Dynamic0823/MacroPad/Kicad/MacroPadV2BOM.ods

Item | Qty | Reference(s) | Value | LibPart | Footprint | Datasheet | DigikeyPN | Field4
1 | 2 | C1, C2 | 15pF | Device:C_Small | Capacitor_SMD:C_0805_2012Metric_Pad1.18x1.45mm_HandSolder | ~ | 311-1101-2-ND
2 | 3 | C3, C4, C5 | 100nF | Device:C_Small | Capacitor_SMD:C_0805_2012Metric_Pad1.18x1.45mm_HandSolder | ~ | 3372-MT05B104M500BDTR-ND
3 | 1 | C6 | 1uF | Device:C_Small | Capacitor_SMD:C_0805_2012Metric_Pad1.18x1.45mm_HandSolder | ~ | 1276-1003-2-ND
4 | 3 | C7, C8, C9 | 4.7uF | Device:C_Small | Capacitor_SMD:C_0805_2012Metric_Pad1.18x1.45mm_HandSolder | ~ | 1276-1244-2-ND
5 | 12 | D1, D2, D3, D4, D5, D6, D7, D8, D9, D10, D11, D12 | TS4148 RBG | symbols:1N4148WX-TP | Diode_SMD:D_0805_2012Metric_Pad1.15x1.40mm_HandSolder |  | 1801-TS4148RBGTR-ND
6 | 1 | D13 | D | Device:D | Diode_SMD:D_0805_2012Metric_Pad1.15x1.40mm_HandSolder | ~ | 1801-TS4148RBGTR-ND
7 | 1 | F1 | OZCH | Device:Polyfuse_Small | mpadfps:OZCHFusr | ~ | 507-1792-2-ND
8 | 1 | H1 | M3Hole | :M3Hole_3 | mpadfps:M3Hole
9 | 1 | H2 | M3Hole | macropad_parts:M3Hole | mpadfps:M3Hole
10 | 1 | H3 | M3Hole | :M3Hole_2 | mpadfps:M3Hole
11 | 1 | H4 | M3Hole | :M3Hole_1 | mpadfps:M3Hole
12 | 3 | J1, J2, J4 | 3PinJump | macropad_parts:3PinJump | Connector_PinHeader_2.54mm:PinHeader_1x03_P2.54mm_Vertical
13 | 1 | J3 | GCT-USB4085 | symbols:GCT-USB4085 | mpadfps:USB4085-GF-A |  | 2073-USB4085-GF-ATR-ND
14 | 3 | J5, J6, J7 | 4PinJump | macropad_parts:4PinJump | Connector_PinHeader_2.54mm:PinHeader_1x04_P2.54mm_Vertical
15 | 12 | K1, K2, K3, K4, K5, K6, K7, K8, K9, K10, K11, K12 | KSW | macropad_parts:KSW | keyboard_fp:CherryMx |  | CH197-ND
16 | 5 | R1, R2, R4, R10, R11 | 10k | Device:R_Small_US | Resistor_SMD:R_0805_2012Metric_Pad1.20x1.40mm_HandSolder | ~ | RMCF0805JT10K0TR-ND
17 | 2 | R3, R5 | 5.1k | Device:R_Small_US | Resistor_SMD:R_0805_2012Metric_Pad1.20x1.40mm_HandSolder | ~ | RMCF0805JT5K10TR-ND
18 | 4 | R6, R7, R8, R9 | 1k | Device:R_Small_US | Resistor_SMD:R_0805_2012Metric_Pad1.20x1.40mm_HandSolder | ~ | RMCF0805FT1K00
19 | 2 | SW1, SW2 | SWITCH_TACTILE_SPST-NO_0.05A_12V | macropad_parts:SWITCH_TACTILE_SPST-NO_0.05A_12V | mpadfps:PTS645-G |  | CKN9085TR-ND
20 | 1 | SW3 | RotaryEncoder_Switch | Device:RotaryEncoder_Switch | mpadfps:PEC11H-RotaryEncoderSwitch | ~ | 118-PEC11H-4220F-S0024-ND
21 | 1 | U1 | STM32F103C8T6TR | symbols:STM32F103C8T6TR | macrofp:LQFP48 |  | 497-17666-2-ND
22 | 1 | U2 | AP2114HA-3.3TRG1 | macropad_parts:AP2114HA-3.3TRG1 | keyboard_fp:SOT-223_DIO-L |  | AP2114HA-3.3TRG1DITR-ND
23 | 1 | X1 | TSX-3225_16.0000MF18X-AC6 | macropad_parts:TSX-3225_16.0000MF18X-AC6 | mpadfps:TSX-3226 |  | SER4372TR-ND | OSC16MHz
