Dynamic0823/MacroPad/Kicad/MacroPadV2.kicad_pcb

## KiCad design Kicad/MacroPadV2.kicad_pcb (2024-02-11)

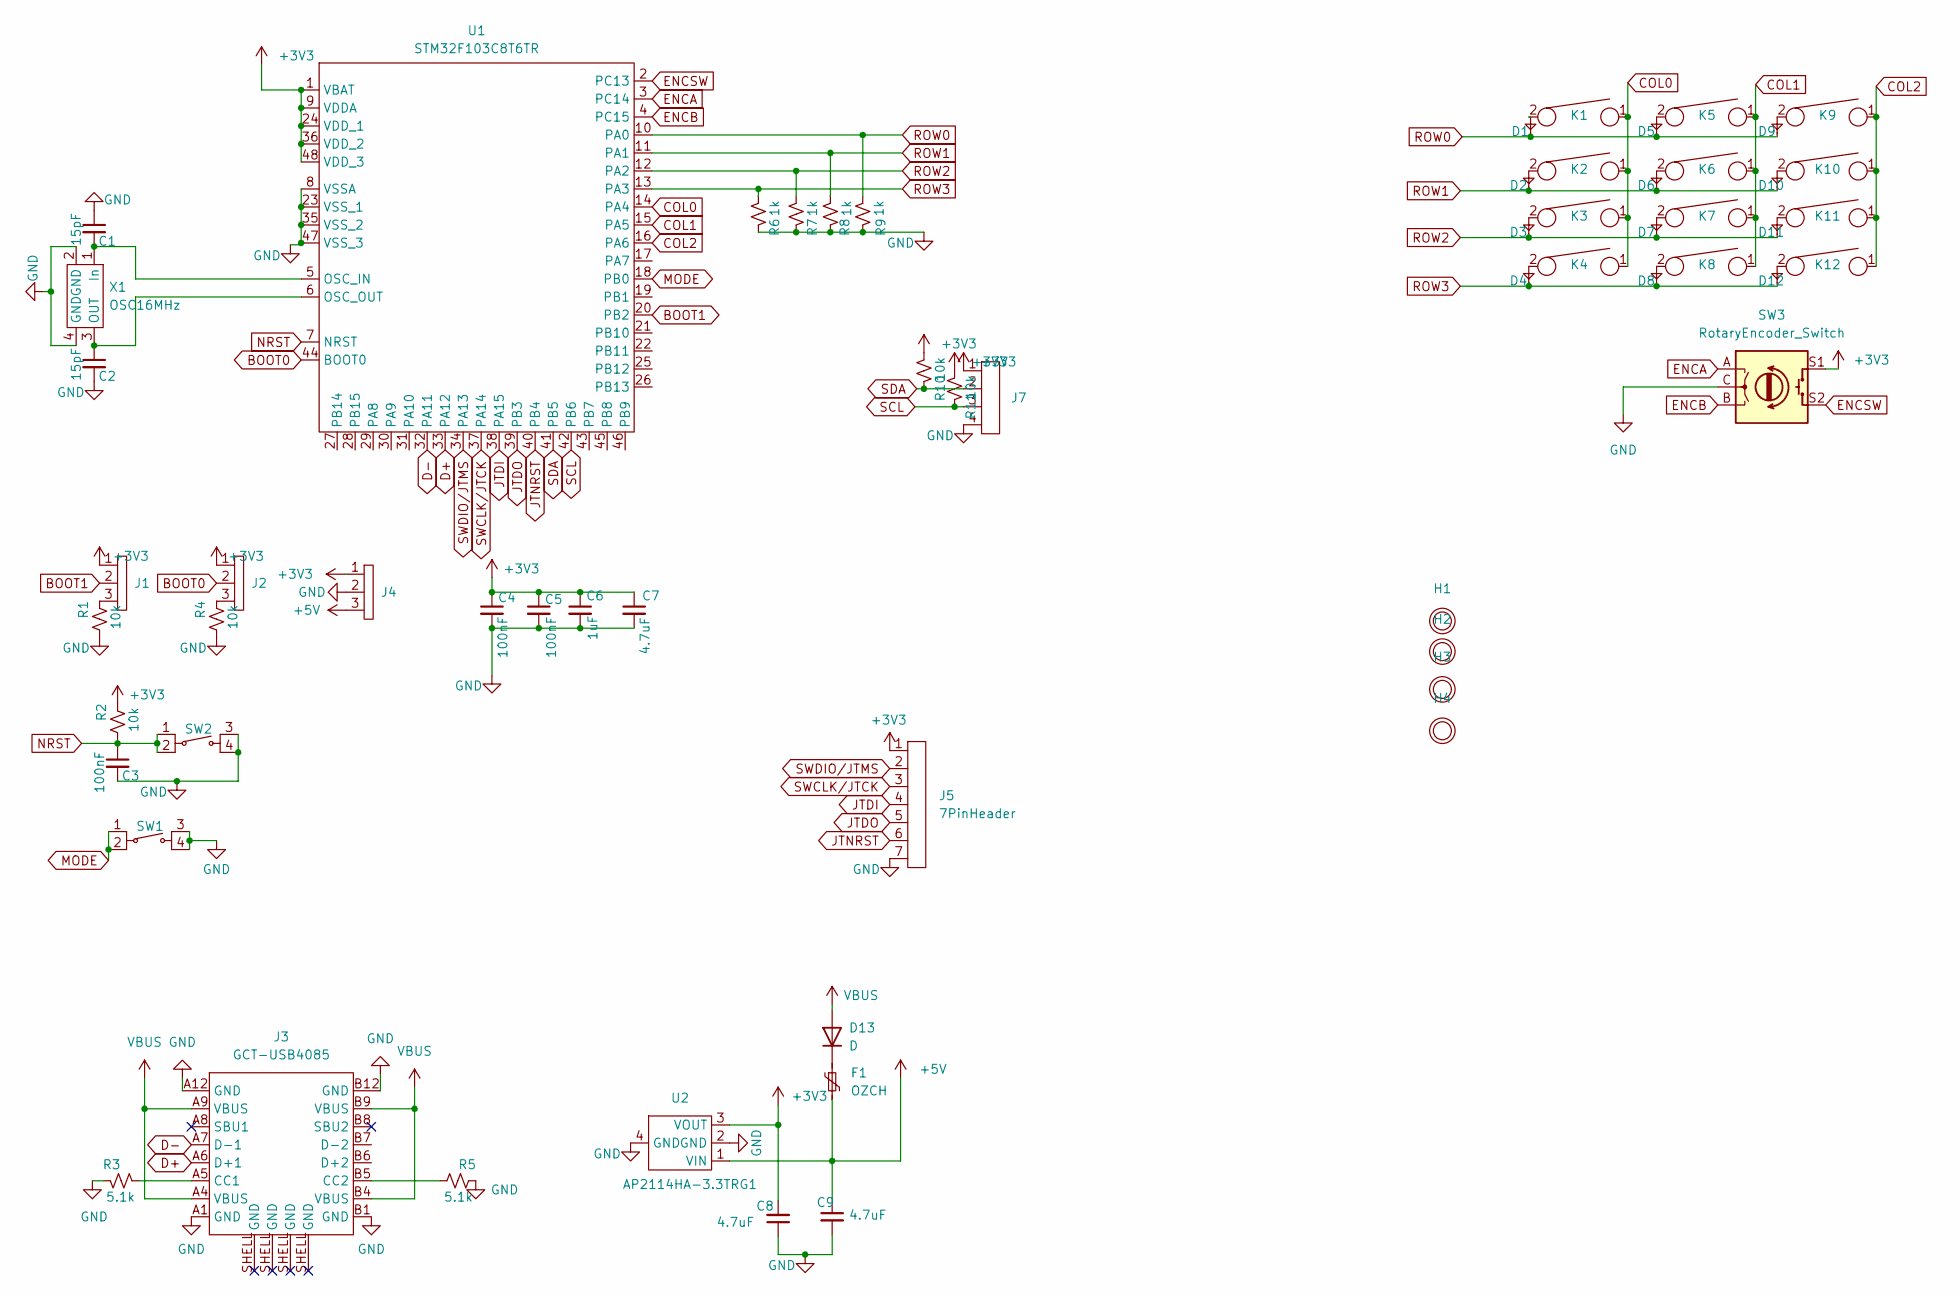
[picture p1: schematic MacroPadV2.kicad_sch]

Parts:
C1, C2: 15pF; C_0805_2012Metric_Pad1.18x1.45mm_HandSolder; DigikeyPN 311-1101-2-ND
C3, C4, C5: 100nF; C_0805_2012Metric_Pad1.18x1.45mm_HandSolder; DigikeyPN 3372-MT05B104M500BDTR-ND
C6: 1uF; C_0805_2012Metric_Pad1.18x1.45mm_HandSolder; DigikeyPN 1276-1003-2-ND
C7, C8, C9: 4.7uF; C_0805_2012Metric_Pad1.18x1.45mm_HandSolder; DigikeyPN 1276-1244-2-ND
D1, D2, D3, D4, D5, D6, D7, D8, D9, D10, D11, D12: TS4148 RBG; D_0805_2012Metric_Pad1.15x1.40mm_HandSolder; DigikeyPN 1801-TS4148RBGTR-ND
D13: D; D_0805_2012Metric_Pad1.15x1.40mm_HandSolder; DigikeyPN 1801-TS4148RBGTR-ND
F1: OZCH; OZCHFusr; DigikeyPN 507-1792-2-ND
H1, H2, H3, H4: M3Hole
J1, J2, J4: 3PinJump; PinHeader_1x03_P2.54mm_Vertical
J3: GCT-USB4085; USB4085-GF-A; DigikeyPN 2073-USB4085-GF-ATR-ND
J5: 7PinHeader; PinHeader_1x07_P2.54mm_Vertical
J7: 4PinJump; PinHeader_1x04_P2.54mm_Vertical
K1, K2, K3, K4, K5, K6, K7, K8, K9, K10, K11, K12: KSW; CherryMx; DigikeyPN CH197-ND
R1, R2, R4, R10, R11: 10k; R_0805_2012Metric_Pad1.20x1.40mm_HandSolder; DigikeyPN RMCF0805JT10K0TR-ND
R3, R5: 5.1k; R_0805_2012Metric_Pad1.20x1.40mm_HandSolder; DigikeyPN RMCF0805JT5K10TR-ND
R6, R7, R8, R9: 1k; R_0805_2012Metric_Pad1.20x1.40mm_HandSolder; DigikeyPN RMCF0805FT1K00
SW1, SW2: SWITCH_TACTILE_SPST-NO_0.05A_12V; PTS645-G; DigikeyPN CKN9085TR-ND
SW3: RotaryEncoder_Switch; PEC11H-RotaryEncoderSwitch; DigikeyPN 118-PEC11H-4220F-S0024-ND
U1: STM32F103C8T6TR; LQFP48; DigikeyPN 497-17666-2-ND
U2: AP2114HA-3.3TRG1; SOT-223_DIO-L; DigikeyPN AP2114HA-3.3TRG1DITR-ND
X1: TSX-3225_16.0000MF18X-AC6; TSX-3226; DigikeyPN SER4372TR-ND

Connections:
+3V3: C4.1, C5.1, C6.1, C7.1, C8.2, J1.1, J2.1, J4.1, J5.1, J7.1, R2.1, R10.2, R11.2, SW3.S1, U1.1 (VBAT), U1.9 (VDDA), U1.24 (VDD_1), U1.36 (VDD_2), U1.48 (VDD_3), U2.3 (VOUT)
+5V: C9.1, F1.2, J4.3, U2.1 (VIN)
BOOT0: J2.2, U1.44 (BOOT0)
BOOT1: J1.2, U1.20 (PB2)
COL0: K1.1, K2.1, K3.1, K4.1, U1.14 (PA4)
COL1: K5.1, K6.1, K7.1, K8.1, U1.15 (PA5)
COL2: K9.1, K10.1, K11.1, K12.1, U1.16 (PA6)
D+: J3.A6 (D+1), U1.33 (PA12)
D-: J3.A7 (D-1), U1.32 (PA11)
ENCA: SW3.A, U1.3 (PC14)
ENCB: SW3.B, U1.4 (PC15)
ENCSW: SW3.S2, U1.2 (PC13)
GND: C1.1, C2.2, C3.2, C4.2, C5.2, C6.2, C7.2, C8.1, C9.2, J3.A1 (GND), J3.A12 (GND), J3.B1 (GND), J3.B12 (GND), J4.2, J5.7, J7.4, R1.2, R3.1, R4.2, R5.1, R6.1, R7.1, R8.1, R9.1, SW1.3, SW1.4, SW2.3, SW2.4, SW3.C, U1.8 (VSSA), U1.23 (VSS_1), U1.35 (VSS_2), U1.47 (VSS_3), U2.2 (GND), U2.4 (GND), X1.2 (GND), X1.4 (GND)
JTDI: J5.4, U1.38 (PA15)
JTDO: J5.5, U1.39 (PB3)
JTNRST: J5.6, U1.40 (PB4)
MODE: SW1.1, SW1.2, U1.18 (PB0)
NRST: C3.1, R2.2, SW2.1, SW2.2, U1.7 (NRST)
unnamed: C1.2, U1.5 (OSC_IN), X1.1 (In)
unnamed: C2.1, U1.6 (OSC_OUT), X1.3 (OUT)
unnamed: D1.1, K1.2
unnamed: D2.1, K2.2
unnamed: D3.1, K3.2
unnamed: D4.1, K4.2
unnamed: D5.1, K5.2
unnamed: D6.1, K6.2
unnamed: D7.1, K7.2
unnamed: D8.1, K8.2
unnamed: D9.1, K9.2
unnamed: D10.1, K10.2
unnamed: D11.1, K11.2
unnamed: D12.1, K12.2
unnamed: D13.1 (K), F1.1
unnamed: J1.3, R1.1
unnamed: J2.3, R4.1
unnamed: J3.A5 (CC1), R3.2
unnamed: J3.B5 (CC2), R5.2
ROW0: D1.2, D5.2, D9.2, R9.2, U1.10 (PA0)
ROW1: D2.2, D6.2, D10.2, R8.2, U1.11 (PA1)
ROW2: D3.2, D7.2, D11.2, R7.2, U1.12 (PA2)
ROW3: D4.2, D8.2, D12.2, R6.2, U1.13 (PA3)
SCL: J7.3, R11.1, U1.42 (PB6)
SDA: J7.2, R10.1, U1.41 (PB5)
SWCLK/JTCK: J5.3, U1.37 (PA14)
SWDIO/JTMS: J5.2, U1.34 (PA13)
VBUS: D13.2 (A), J3.A4 (VBUS), J3.A9 (VBUS), J3.B4 (VBUS), J3.B9 (VBUS)

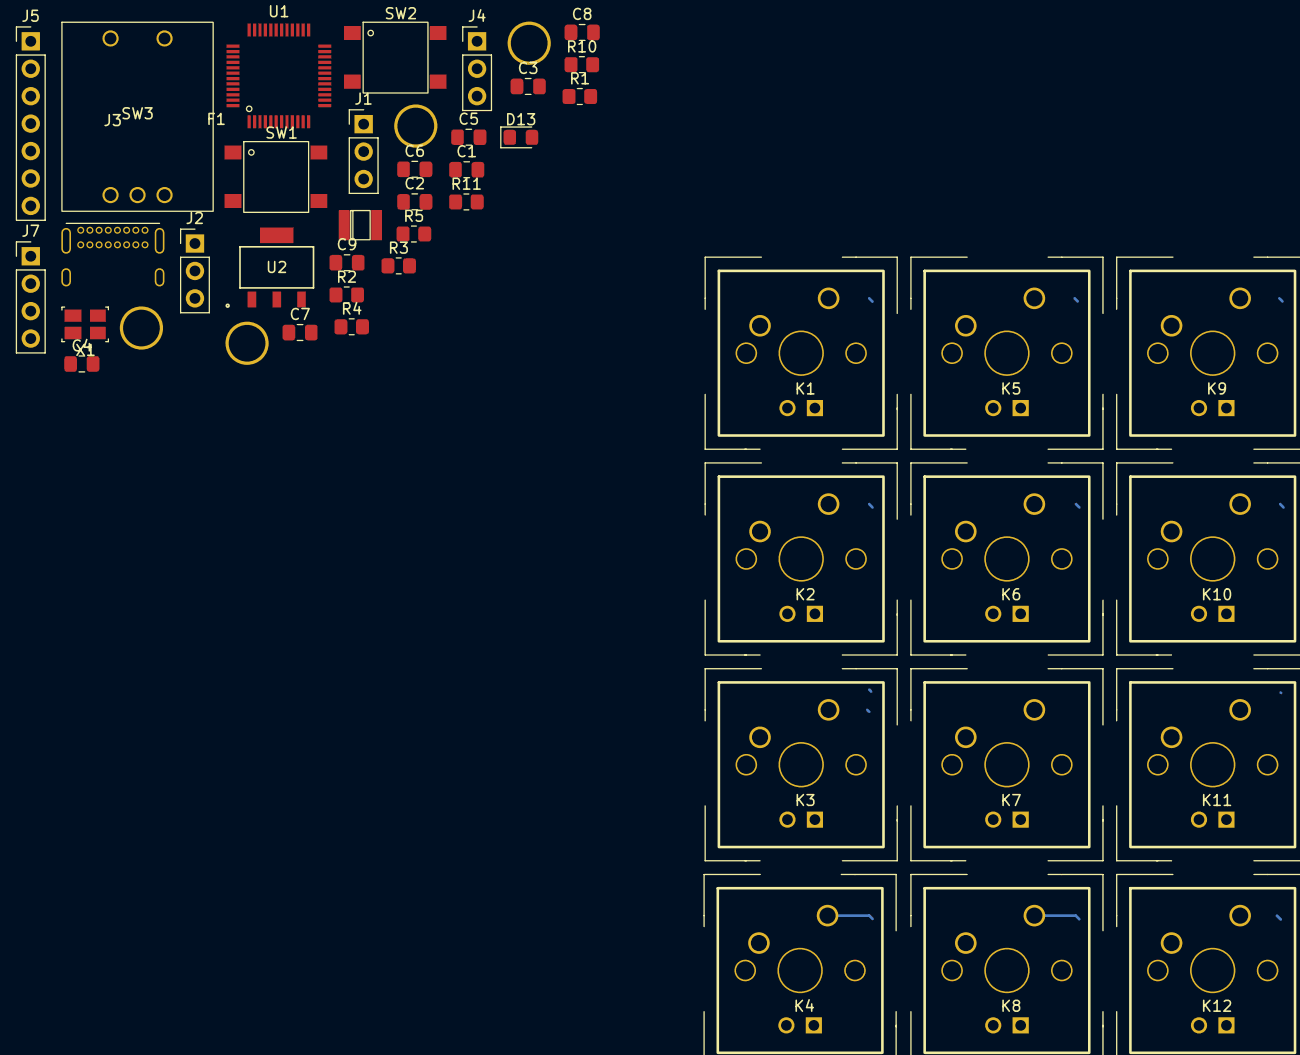
[picture p2: board MacroPadV2.kicad_pcb from above]

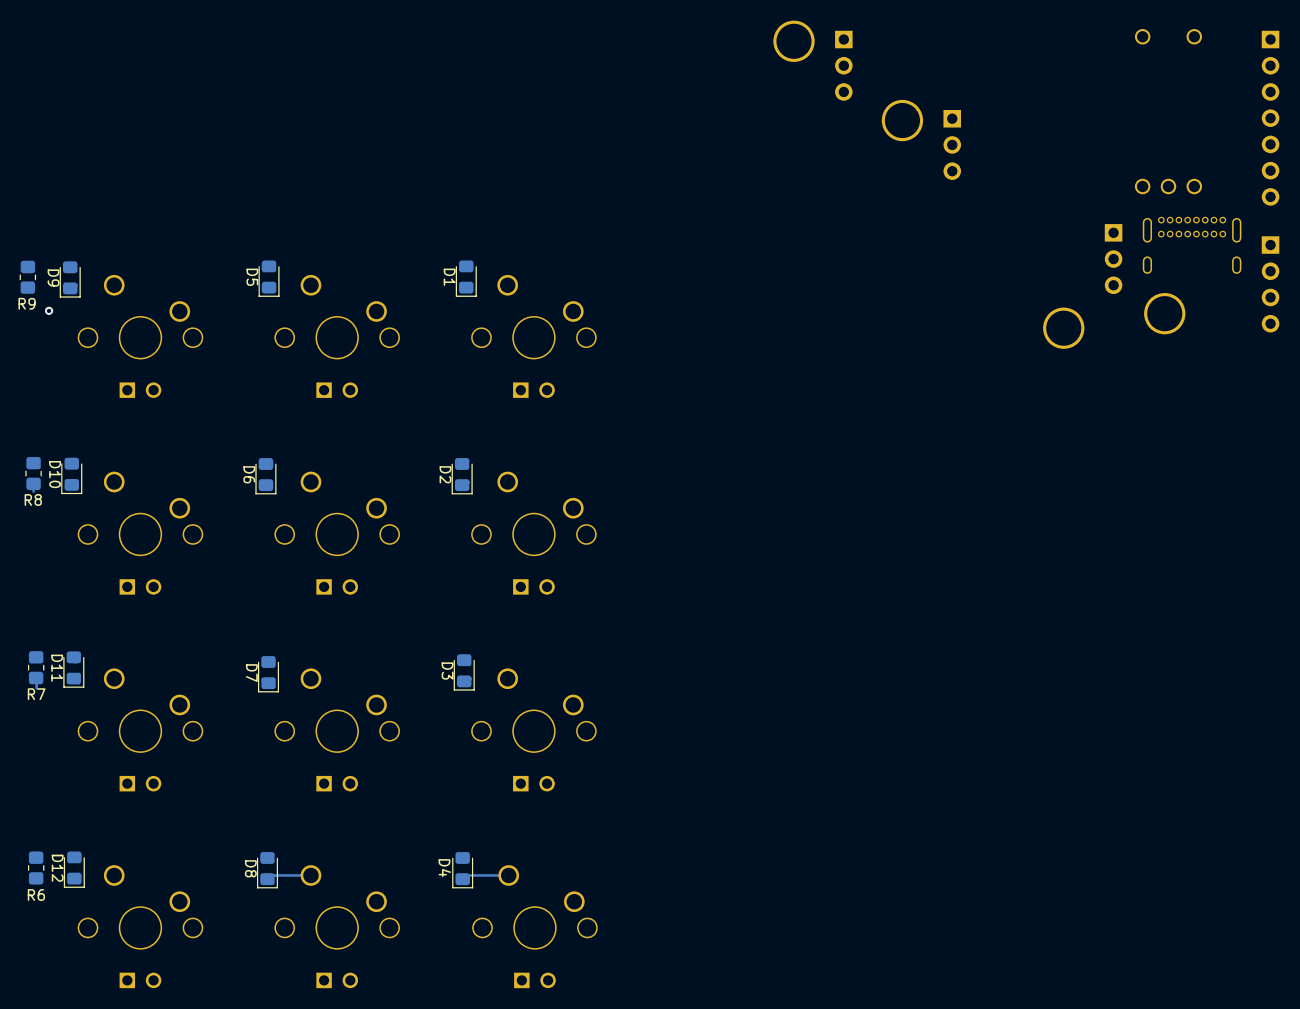
[picture p3: board MacroPadV2.kicad_pcb from below]

Board: 4 copper layers, 62 parts (16 on the bottom side), 46 nets.
