Dynamic0823/MacroPad/(commit log)

2023-12-18 First Commit With Kicad Schem and Fps
    [MacroPadV2.kicad_pcb, MacroPadV2.kicad_sch]
2023-12-28 Added Arduino Project
2023-12-28 Started V2 -More space between keys(keycaps didnt fit) -Pull Down Resistors for Columns and Rotary Switch(ATMega32U4 is internal pull up) -Slightly larger board and edge holes
    [MacroPadV2.kicad_pcb, MacroPadV2.kicad_sch]
2023-12-28 Small changes
    [MacroPadV2.kicad_sch]
2023-12-28 Now we read the gpio port register for columns instead of doing 4 digitalReads. -Soldered Pull Down Resistors to Pull down lines -enc butt needs pull down -change target row/col each successful press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
2023-12-28 Edit: IM AN IDIOT -ROWS ARE THE INPUTS, COLS ARE THE OUTPUTS -Set Cols Low to read a set, then all high after -Removed Pull down resistors on cols
    [MacroPadV2.kicad_sch]
2023-12-29 V2 Schem and Routing Complete for drop in micro pro, making new branch for STM32F103
    [MacroPadV2.kicad_pcb, MacroPadV2.kicad_sch]
2023-12-30 New LAyout an Routing done
    [MacroPadV2.kicad_pcb, MacroPadV2.kicad_sch]
2024-01-16 Fully Finished MacroPad V2 Schematic and Layout with stm32. Ordered and waiting for board to come in. -If there are no issues running the board, this should be the last commit for Kicad files. All pr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
    [MacroPadV2.kicad_pcb, MacroPadV2.kicad_sch, MacroPadV2BOM.ods]
2024-02-11 Removed some backups and push for swap to desktop
    [MacroPadV2.kicad_pcb, MacroPadV2.kicad_sch]
